notro99/arduino-game-box/documentation/fedolap.docx

Szegedi Tudományegyetem

Informatikai Intézet

SZAKDOLGOZAT

Tér Ábel

2021

Szegedi Tudományegyetem

Informatikai Intézet

Moduláris Arduino játékdoboz bemutató alkalmakra

Modular Arduino game box for demonstrational purposes

Szakdolgozat

| Készítette: | | Témavezető:
| Tér Ábel | | Dr. Mingesz Róbert
| mérnökinformatikus BSc szakos hallgató | | egyetemi adjunktus

Szeged

2021
