notro99/arduino-game-box/fritzing/exported_images/breadboard/led_runner_bb.png

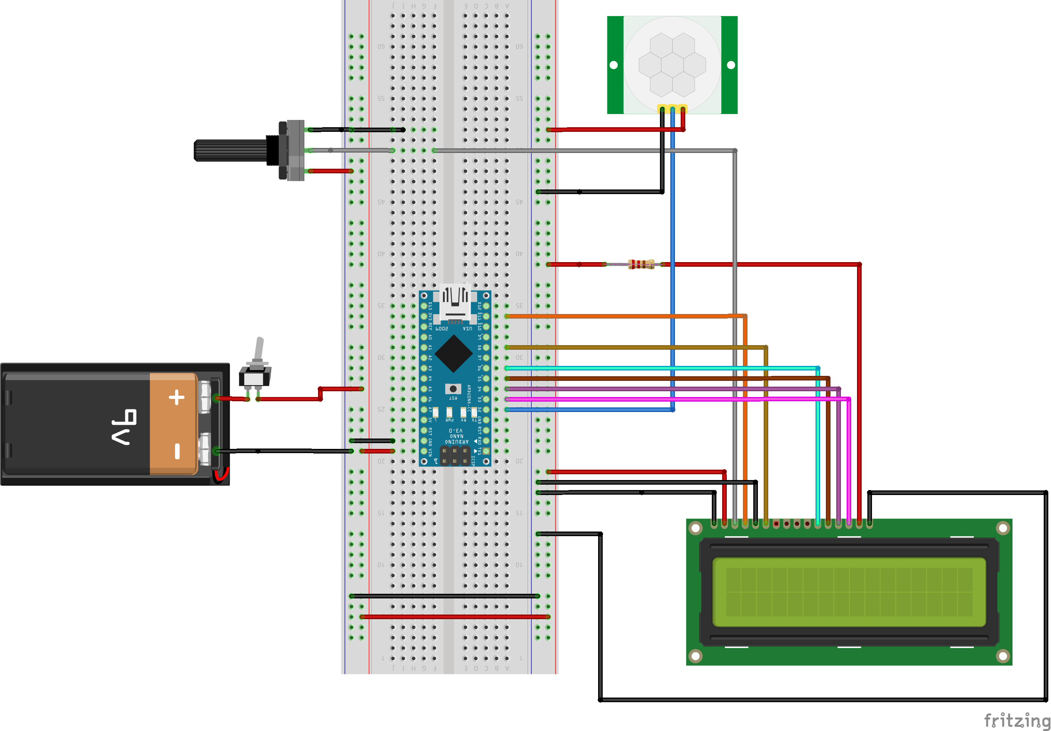
fritzing/exported_images/breadboard/led_runner_bb.png
