notro99/arduino-game-box/fritzing/exported_images/breadboard/memory_4led_bb.png

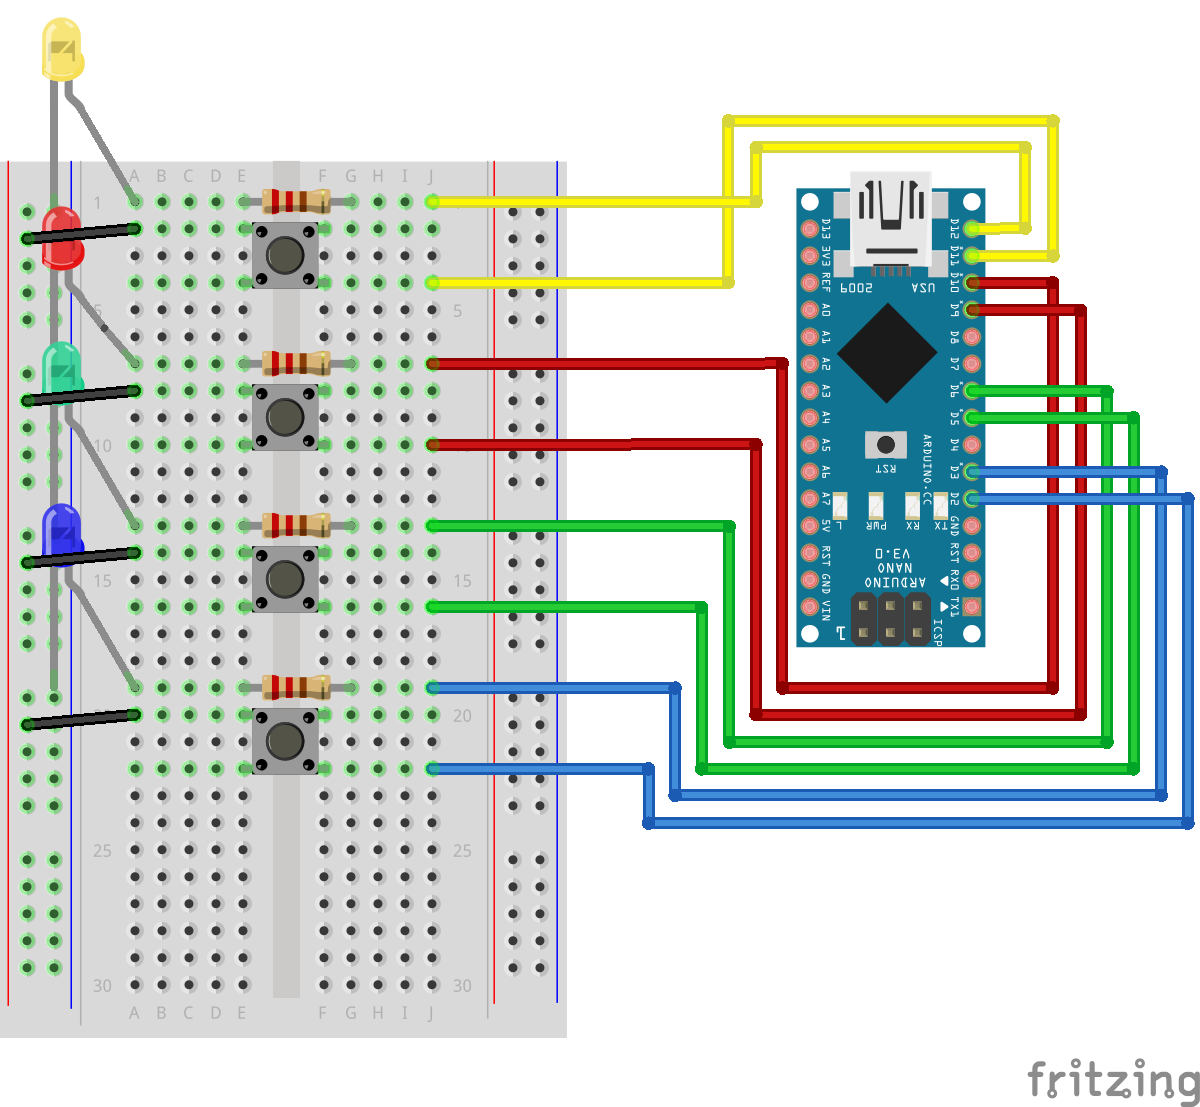
fritzing/exported_images/breadboard/memory_4led_bb.png
