notro99/arduino-game-box/fritzing/exported_images/breadboard/memory_5led_bb.png

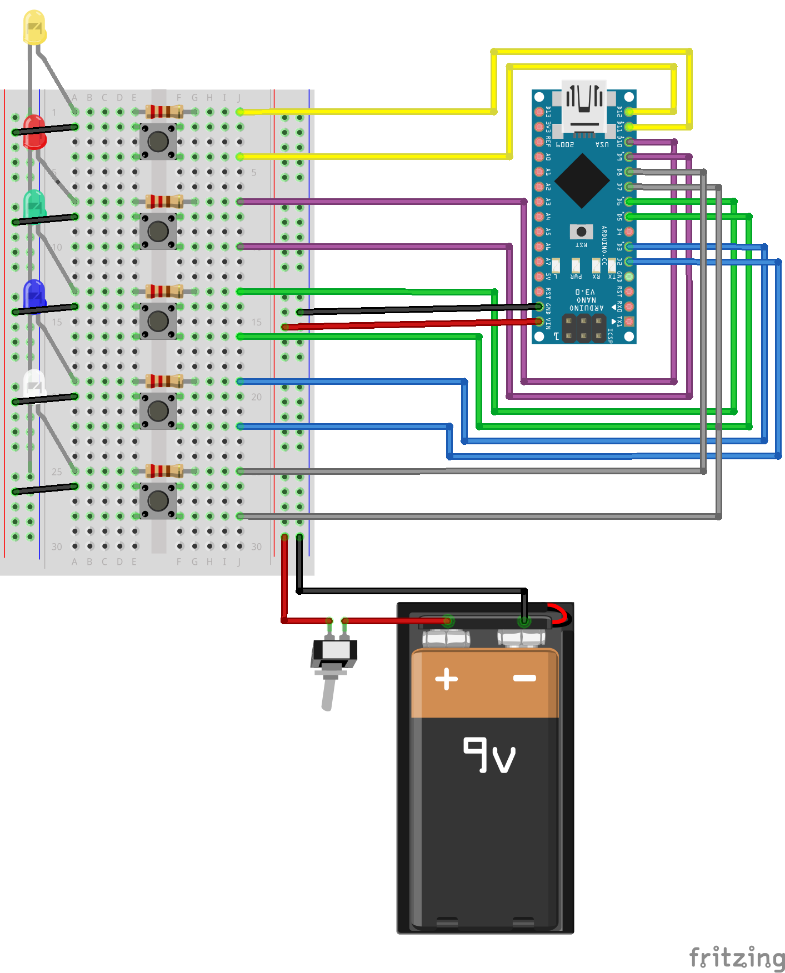
fritzing/exported_images/breadboard/memory_5led_bb.png
