notro99/arduino-game-box/fritzing/exported_images/breadboard/snake_bb.png

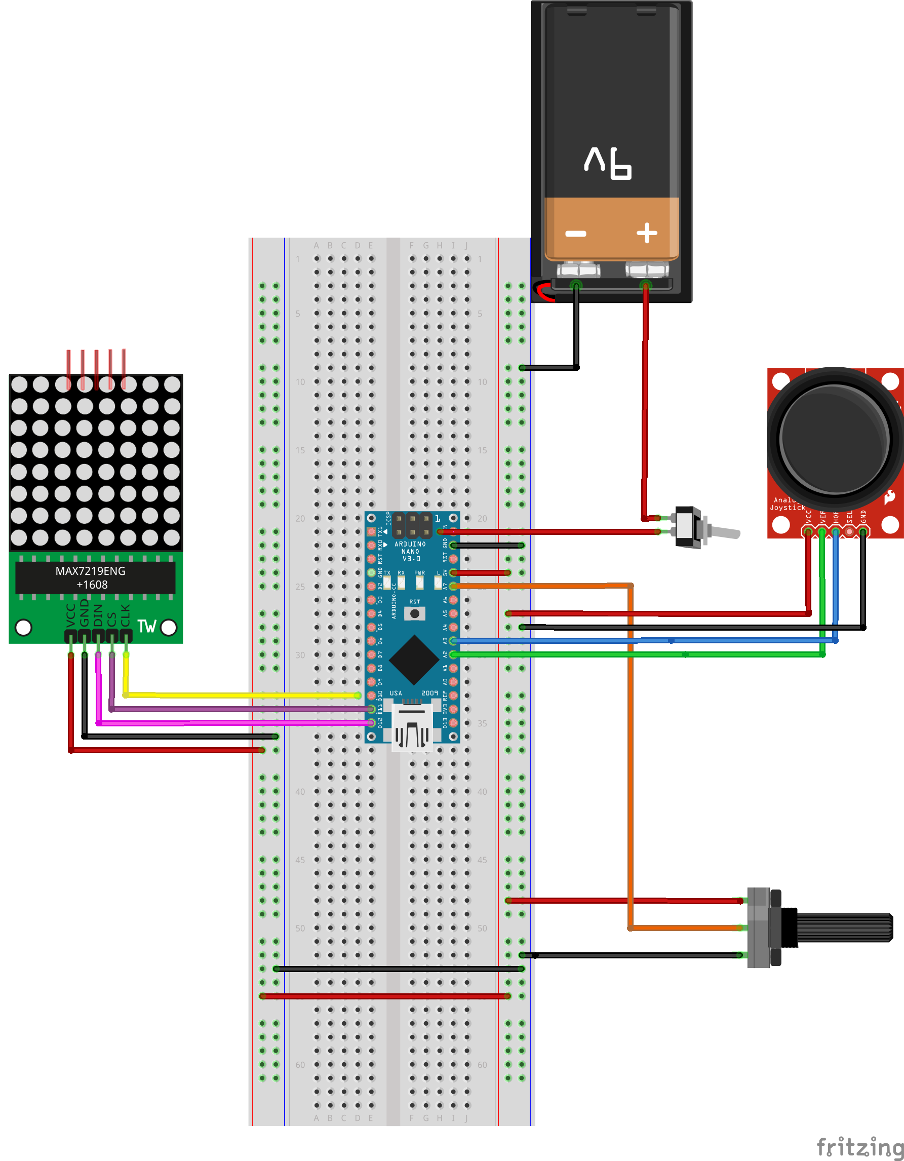
fritzing/exported_images/breadboard/snake_bb.png
