notro99/arduino-game-box/fritzing/exported_images/breadboard/snake_bb_v2.png

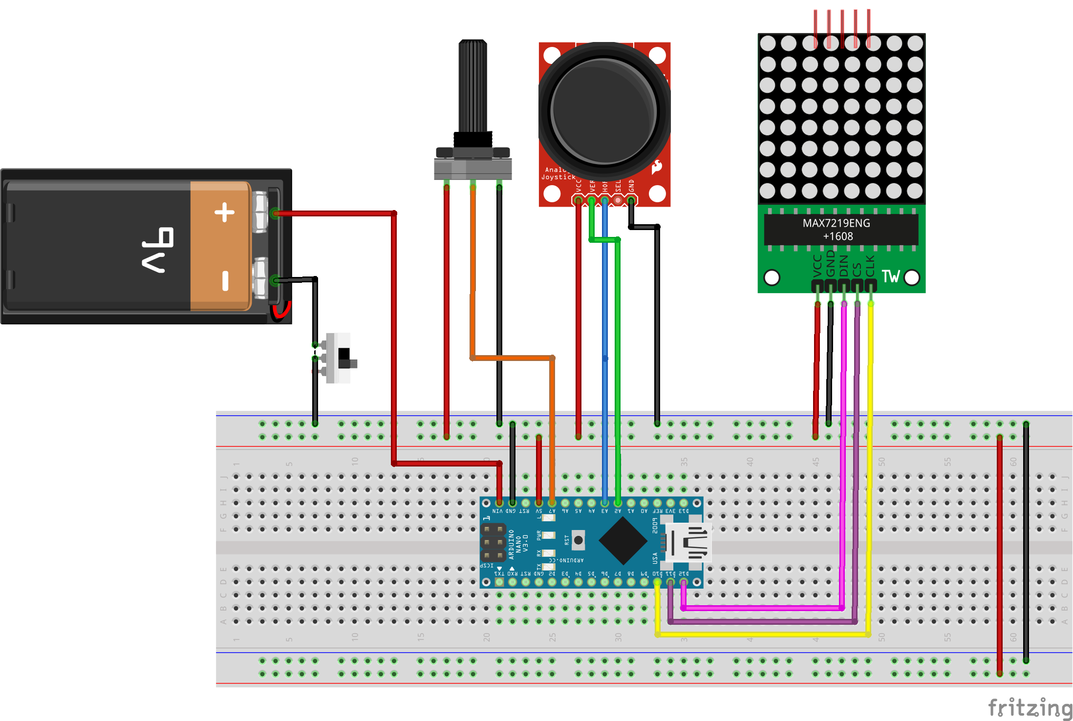
fritzing/exported_images/breadboard/snake_bb_v2.png
