notro99/arduino-game-box/fritzing/exported_images/schemas/led_runner_schem.png

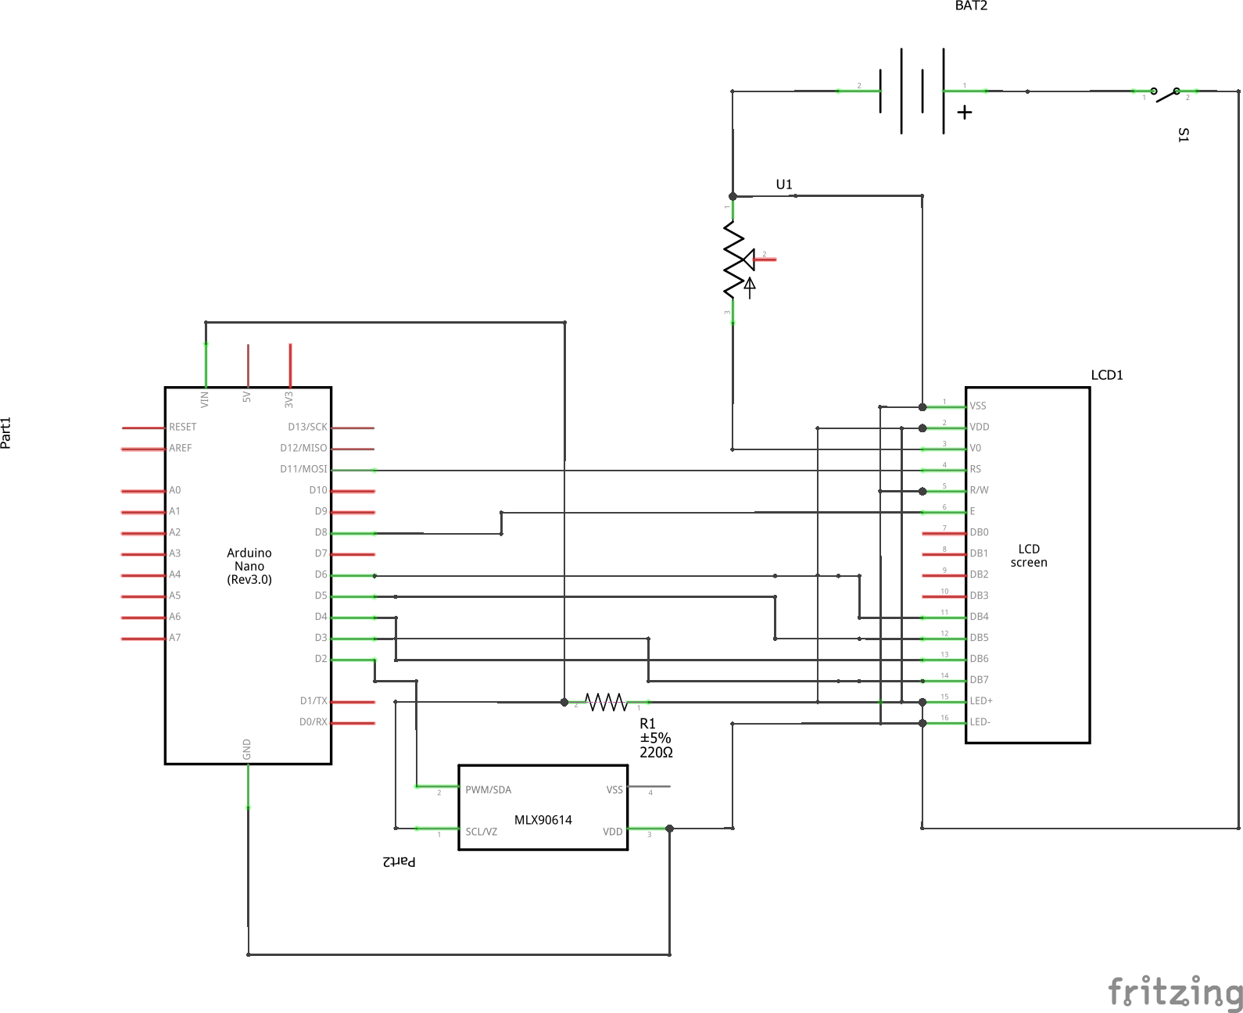
fritzing/exported_images/schemas/led_runner_schem.png
