notro99/arduino-game-box/fritzing/exported_images/schemas/lock_schem.png

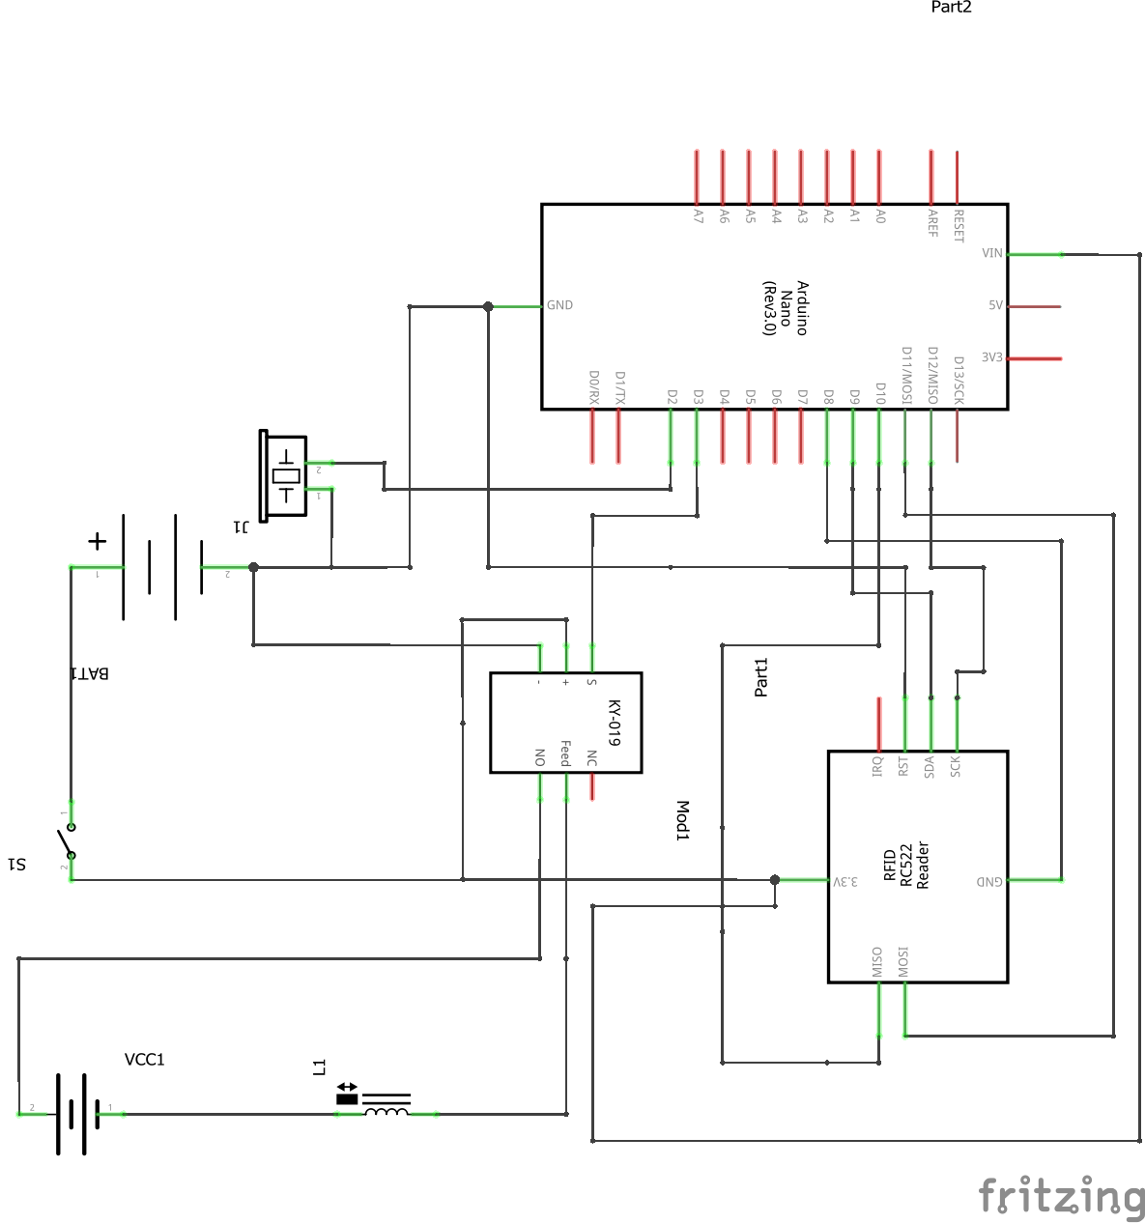
fritzing/exported_images/schemas/lock_schem.png
