notro99/arduino-game-box/fritzing/exported_images/schemas/memory_4led_schem.png

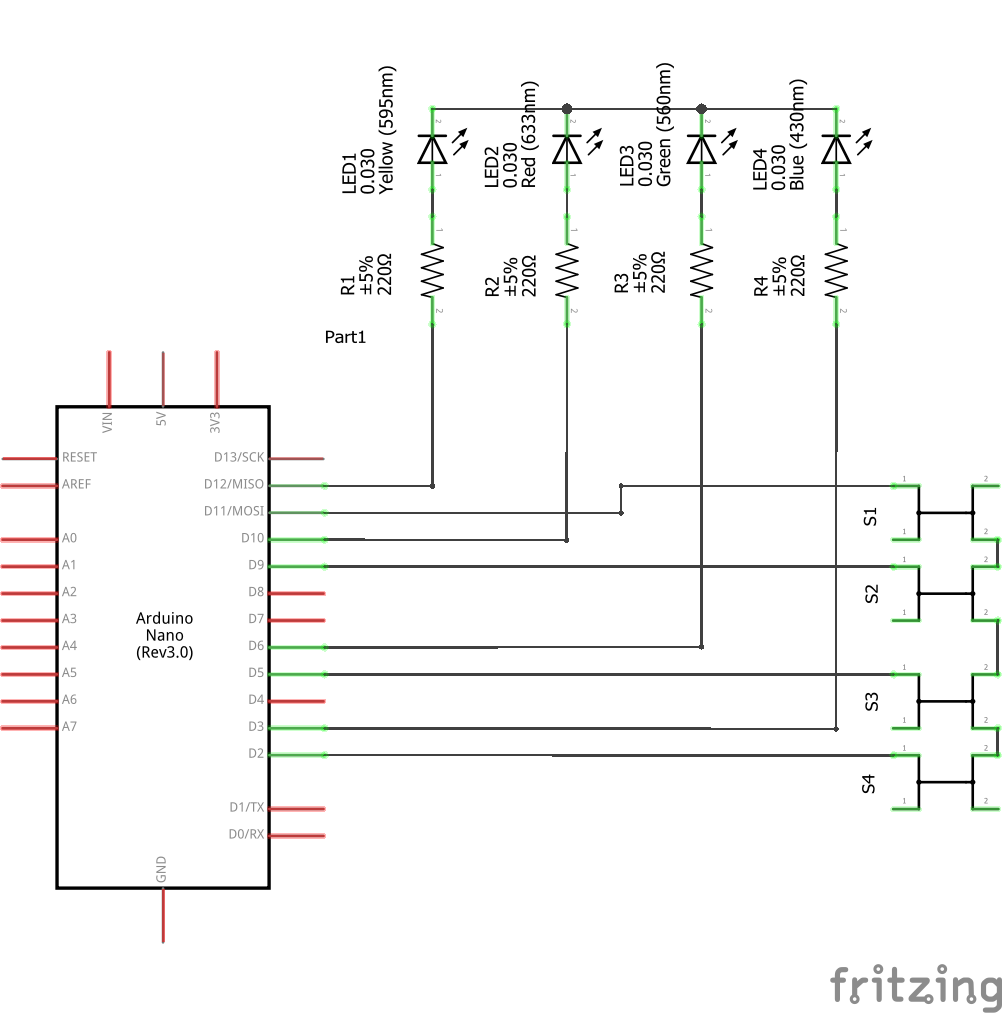
fritzing/exported_images/schemas/memory_4led_schem.png
