notro99/arduino-game-box/fritzing/exported_images/schemas/memory_5led_schem.png

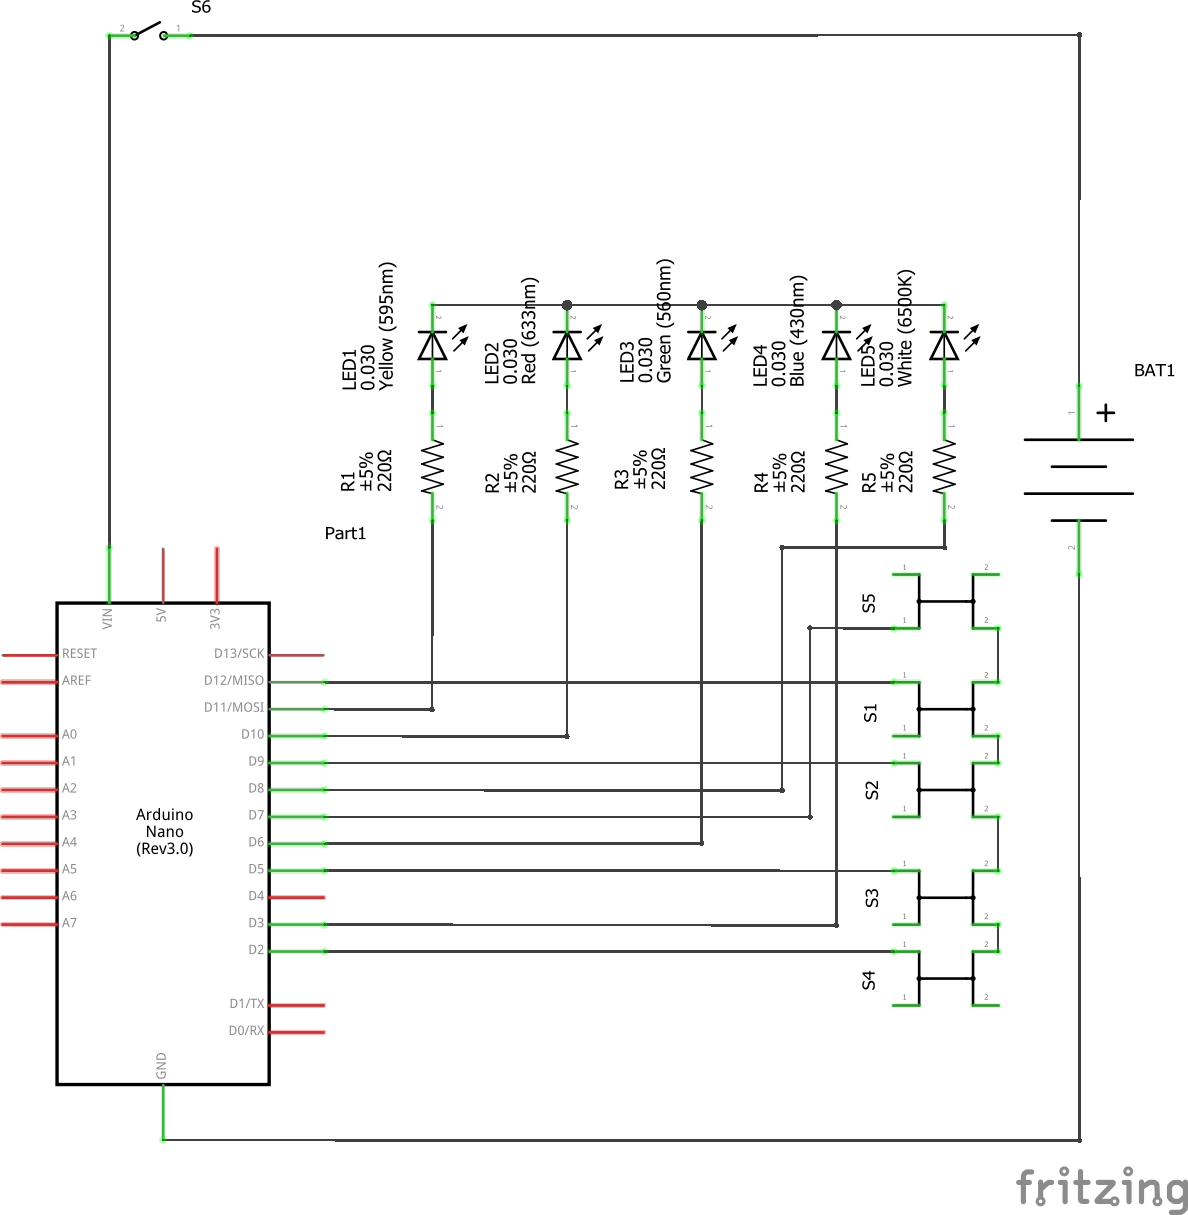
fritzing/exported_images/schemas/memory_5led_schem.png
