notro99/arduino-game-box/fritzing/exported_images/schemas/snake_schem.png

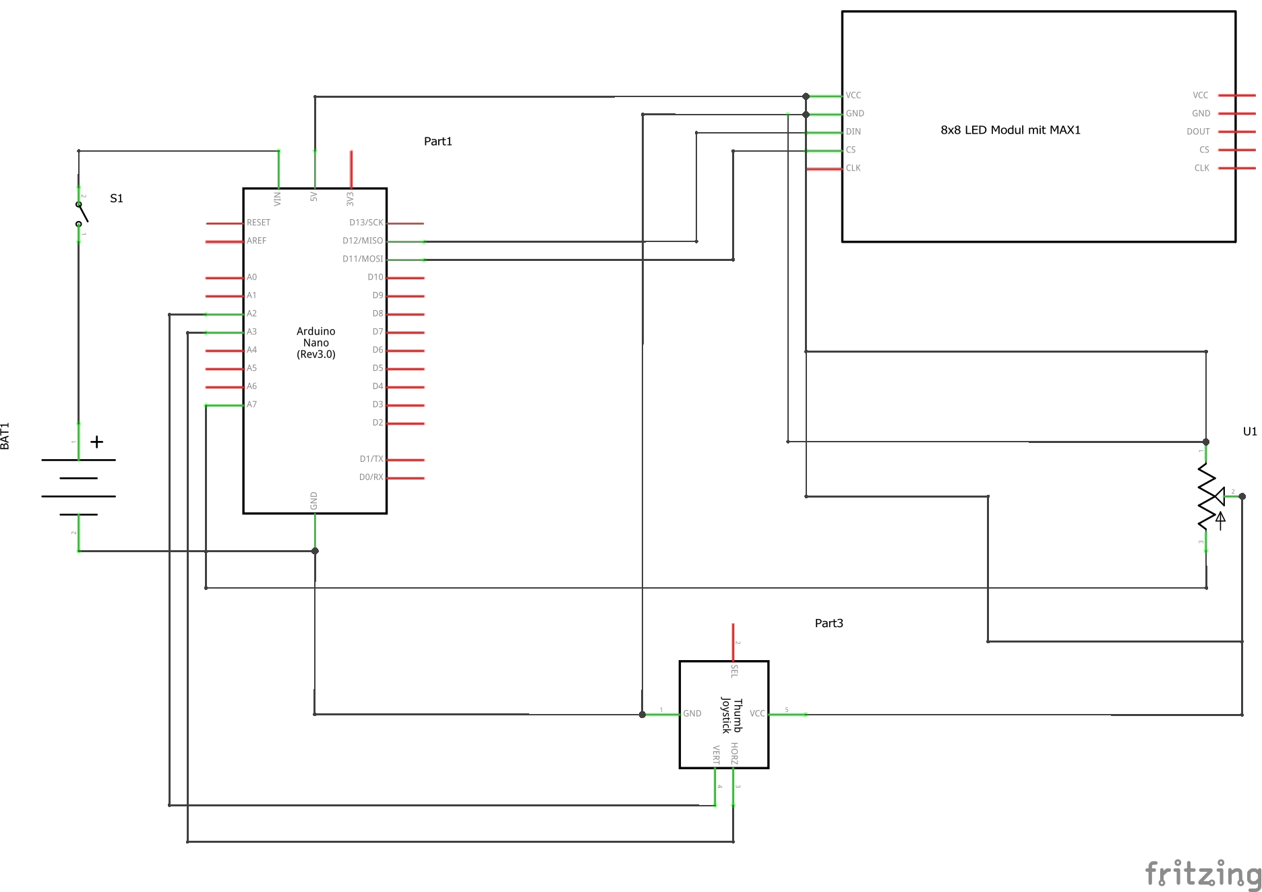
fritzing/exported_images/schemas/snake_schem.png
