notro99/arduino-game-box/3d/snake_fedo_print.stl

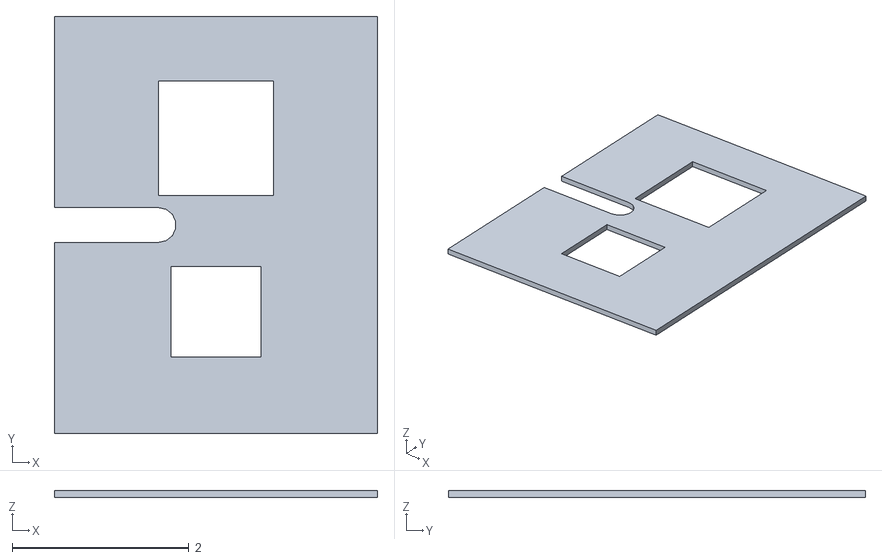
[picture p23: CAD file, 2021-11-20]
3d/snake_fedo_print.stl
3.66 x 4.72 x 0.0787
