notro99/arduino-game-box/3d/alap_print.stl

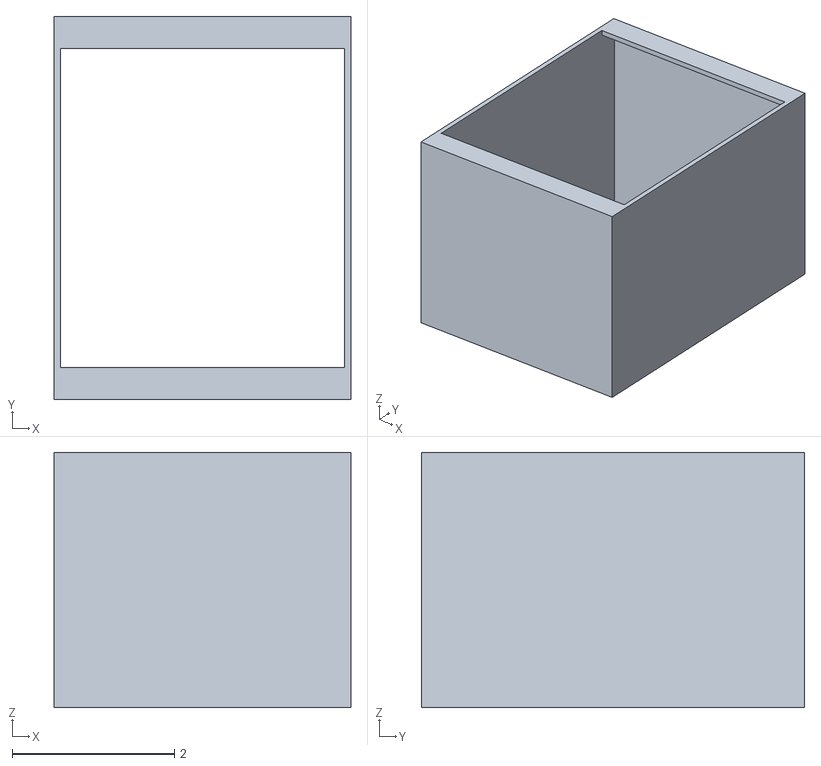
[picture p25: CAD file, 2021-11-20]
3d/alap_print.stl
3.66 x 4.72 x 3.15
