notro99/arduino-game-box/3d/matrix_holder_print.stl

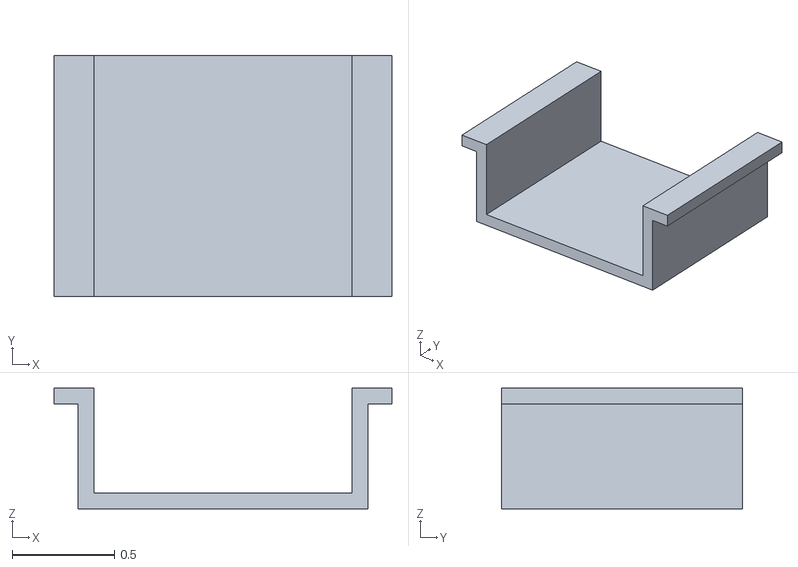
[picture p26: CAD file, 2021-11-20]
3d/matrix_holder_print.stl
1.65 x 1.18 x 0.591
