notro99/arduino-game-box/3d/joystick_holder_print.stl

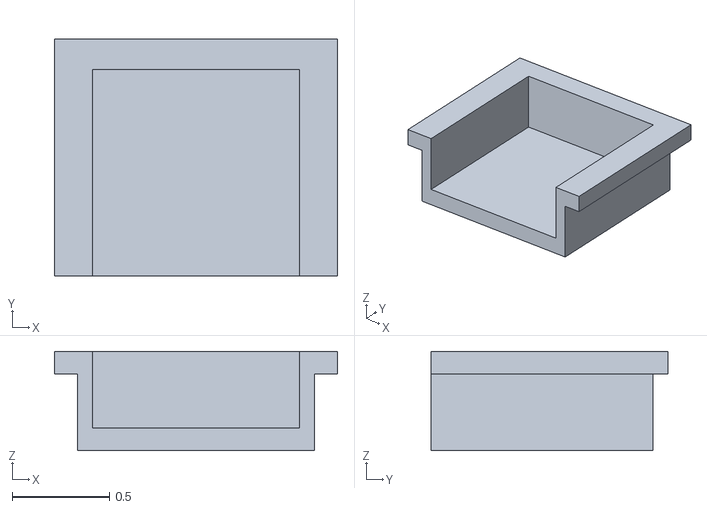
[picture p27: CAD file, 2021-11-20]
3d/joystick_holder_print.stl
1.46 x 1.22 x 0.512
