notro99/arduino-game-box/3d/dino_run_fedo_print.stl

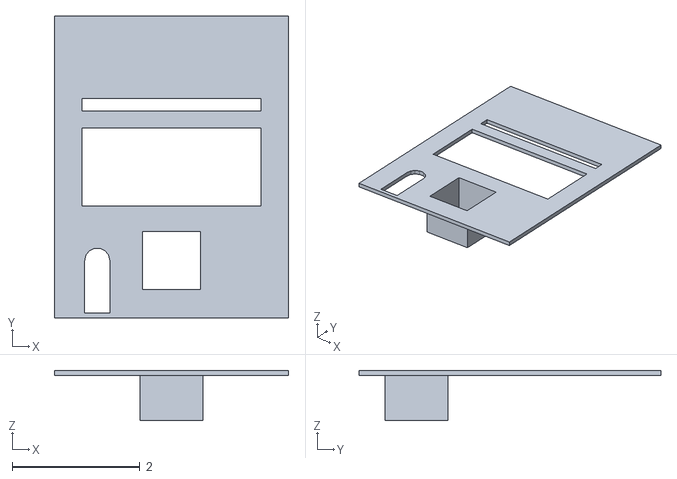
[picture p28: CAD file, 2021-11-20]
3d/dino_run_fedo_print.stl
3.66 x 4.72 x 0.787
