notro99/arduino-game-box/3d/fedo.stl

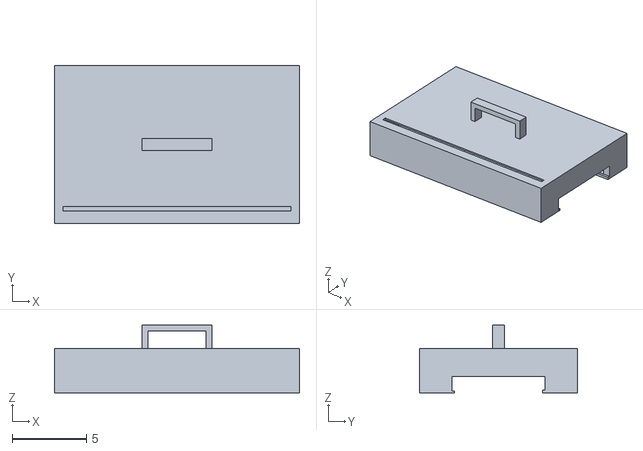
[picture p29: CAD file, 2021-11-09]
3d/fedo.stl
16.5 x 10.6 x 4.57
