notro99/arduino-game-box/3d/dino_run_print.stl

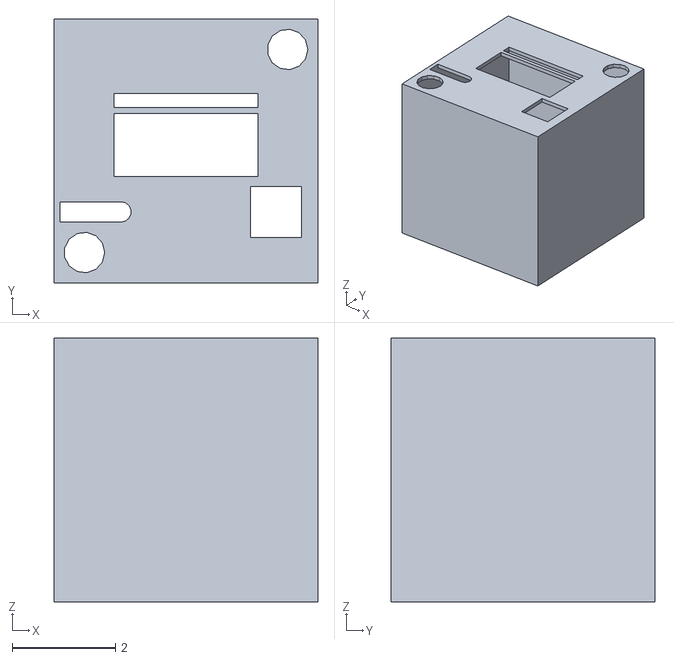
[picture p30: CAD file, 2021-11-09]
3d/dino_run_print.stl
5.12 x 5.12 x 5.12
