notro99/arduino-game-box/3d/snake_print.stl

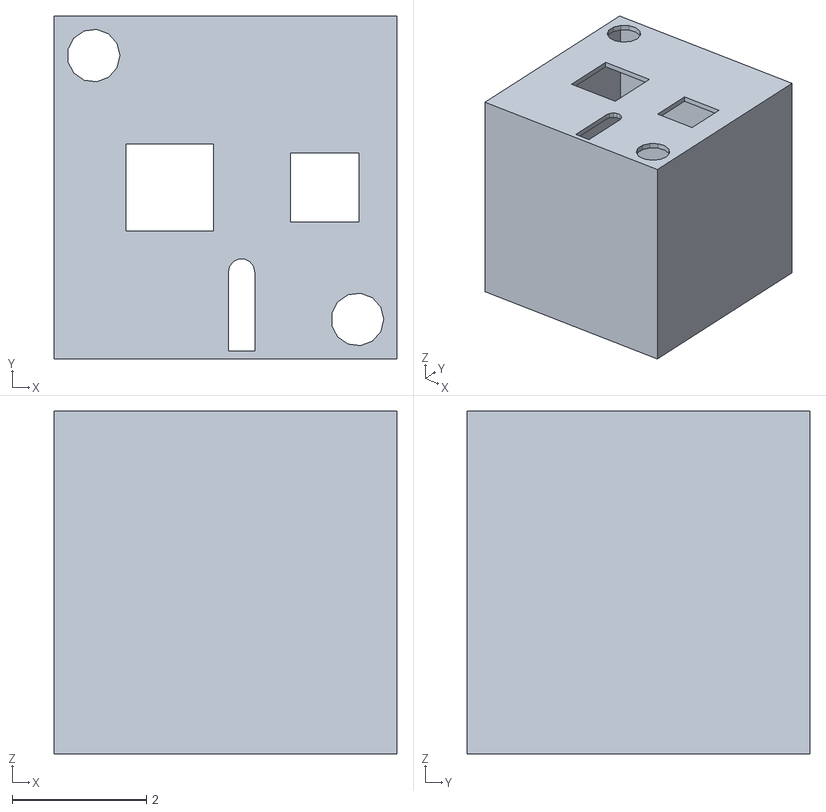
[picture p31: CAD file, 2021-11-09]
3d/snake_print.stl
5.12 x 5.12 x 5.12
