notro99/arduino-game-box/3d/lada_print.stl

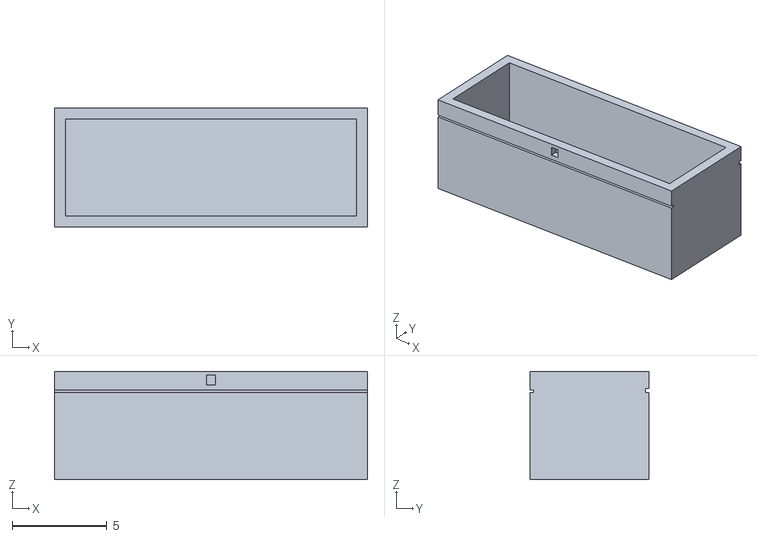
[picture p32: CAD file, 2021-11-09]
3d/lada_print.stl
16.5 x 6.30 x 5.71
