notro99/arduino-game-box/(list of files, cad)

Other CAD files:
3d/memory_print.stl
