notro99/arduino-game-box/(list of files, drawings)

Other design files:
fritzing/led_runner.fzz
fritzing/projects/led_runner.fzz
fritzing/projects/lock.fzz
fritzing/projects/memory_4led.fzz
fritzing/projects/memory_5led.fzz
fritzing/projects/memory_5led_v2.fzz
fritzing/projects/snake.fzz
