notro99/arduino-game-box/source_codes/runningtext/runningtext.ino

//Viral Science  www.viralsciencecreativity.com  www.youtube.com/c/viralscience
//LED 8x8 Matrix Display DEMO

#include <LedControl.h>
int DIN = 10;
int CS =  9;
int CLK = 8;

LedControl lc=LedControl(DIN,CLK,CS,0);

void setup(){
 lc.shutdown(0,false);       
 lc.setIntensity(0,4);      //Adjust the brightness maximum is 15
 lc.clearDisplay(0);    
}

void loop(){ 
    
    byte a0[8]=   {0x00,0x00,0x00,0x00,0x00,0x00,0x00,0x00};
    byte a1[8]=   {0x00,0x00,0x00,0x00,0x01,0x01,0x01,0x01};
    byte a2[8]=   {0x00,0x00,0x00,0x01,0x02,0x03,0x02,0x02};
    byte a3[8]=   {0x00,0x00,0x01,0x02,0x04,0x07,0x04,0x04};
    byte a4[8]=   {0x00,0x00,0x03,0x04,0x08,0x0F,0x08,0x08};
    byte a5[8]=   {0x01,0x01,0x06,0x09,0x10,0x1F,0x10,0x10};
    byte a6[8]=   {0x02,0x02,0x0C,0x12,0x21,0x3F,0x21,0x21};
    byte a7[8]=   {0x02,0x02,0x18,0x24,0x42,0x7E,0x42,0x42};

    
    byte b0[8]=   {0x08,0x08,0x21,0x51,0x89,0xF9,0x89,0x89};
    byte b1[8]=   {0x10,0x10,0x43,0xA2,0x13,0xF2,0x12,0x13};
    byte b2[8]=   {0x20,0x20,0x86,0x45,0x27,0xE4,0x24,0x27};
    byte b3[8]=   {0x40,0x40,0x0E,0x89,0x4E,0xC9,0x49,0x4F};
    byte b4[8]=   {0x80,0x80,0x1C,0x12,0x9C,0x92,0x92,0x9E};
    byte b5[8]=   {0x00,0x00,0x38,0x24,0x38,0x24,0x24,0x38};

    byte e0[8]=   {0x00,0x00,0x71,0x49,0x71,0x49,0x49,0x79};
    byte e1[8]=   {0x00,0x00,0xE3,0x92,0xE3,0x92,0x92,0xE3};
    byte e2[8]=   {0x00,0x00,0xC7,0x24,0xC7,0x24,0x24,0xE7};
    byte e3[8]=   {0x00,0x00,0x8F,0x48,0x8E,0x48,0x48,0xCF};
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
   printByte(l5);delay(100);
   printByte(l6);delay(100);
   printByte(l7);delay(100);
   printByte(l8);delay(100);
   printByte(l9);delay(100);
   printByte(l10);delay(100);
 
}

void printByte(byte character [])
{
  int i = 0;
  for(i=0;i<8;i++)
  {
    lc.setRow(0,i,character[i]);
  }
}
