notro99/arduino-game-box/(commit log)

2021-10-12 memory & snake | fritzing
    [memory_4led.fzz, memory_5led.fzz, snake.fzz]
2021-10-27 flowcharts #1
2021-11-09 3d docs
    [dino_run_print.stl, egyutt.cfg, fedo.stl, lada_print.stl, snake_print.stl]
